NiHaoMike/OpenDAC-HD/OpenDAC.JPG

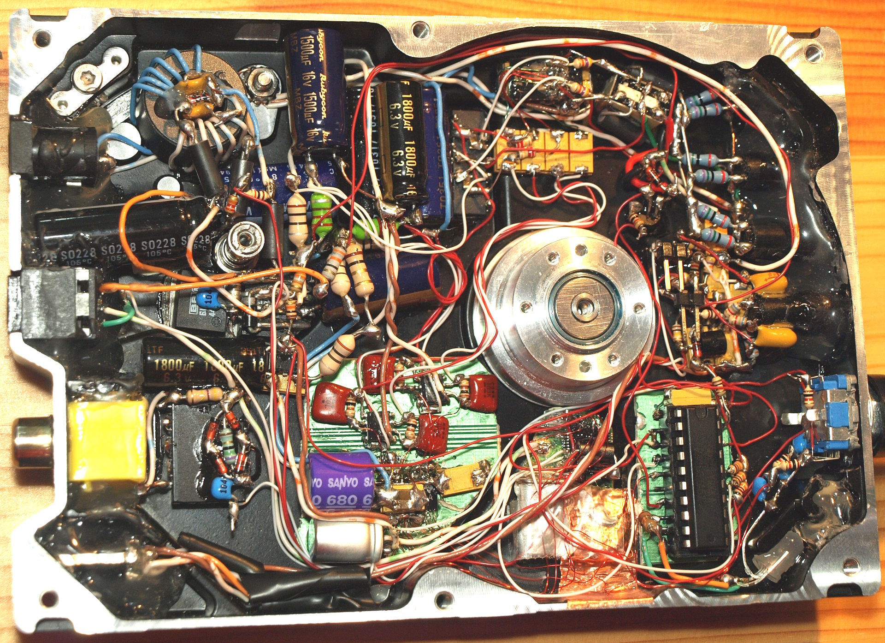
OpenDAC.JPG
