NiHaoMike/OpenDAC-HD/OpenDAC_sch_ana.png

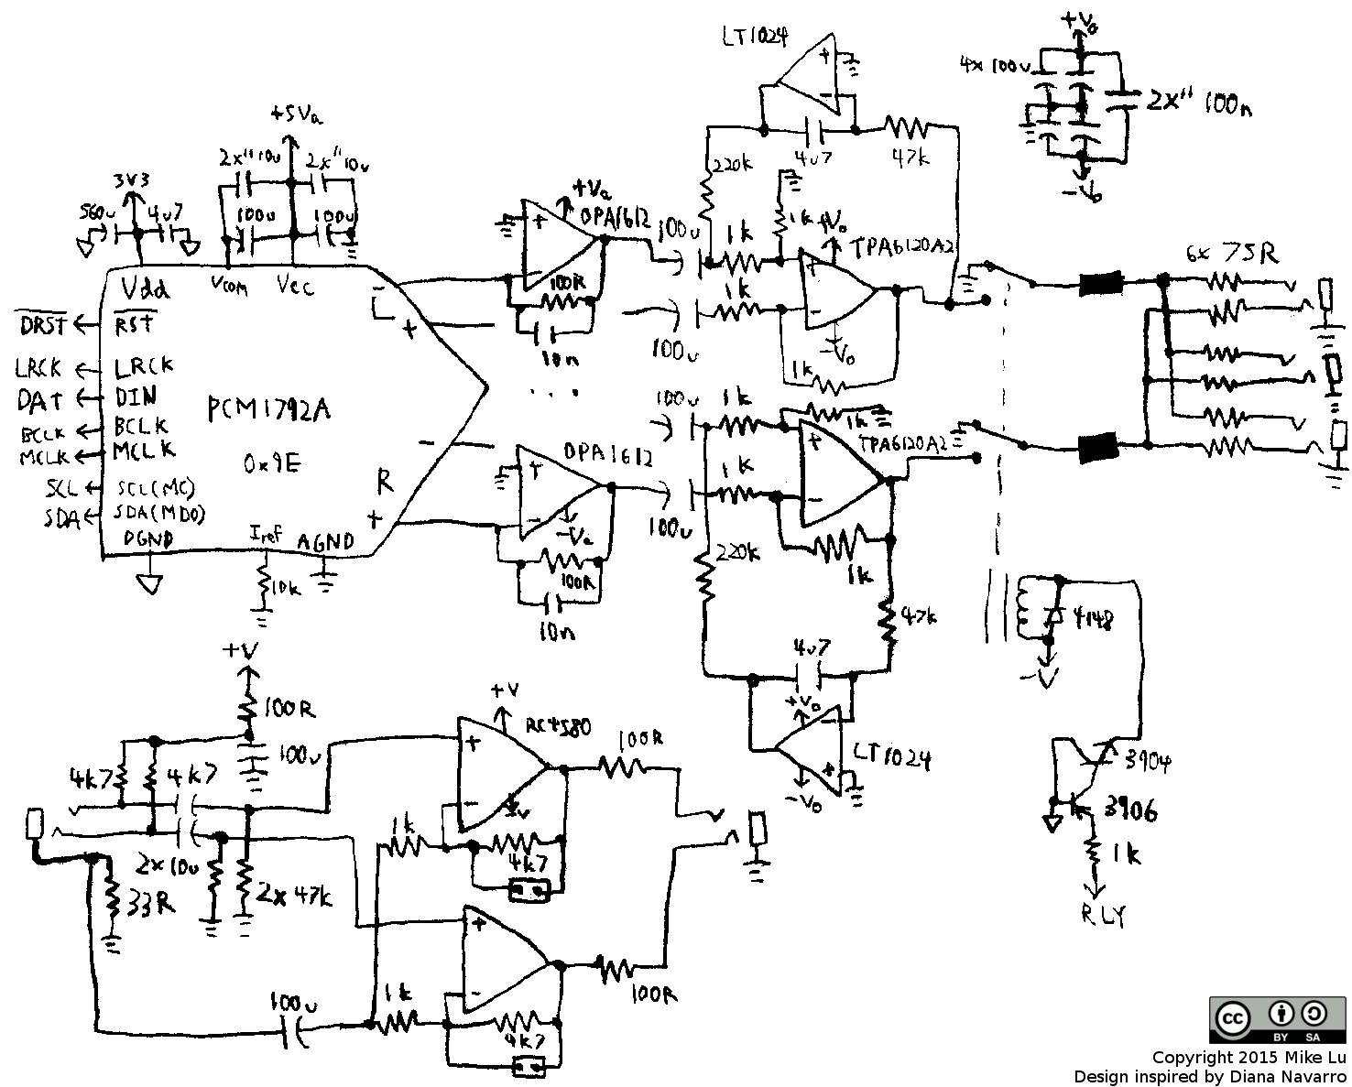
OpenDAC_sch_ana.png
