NiHaoMike/OpenDAC-HD/OpenDAC_sch_dig.png

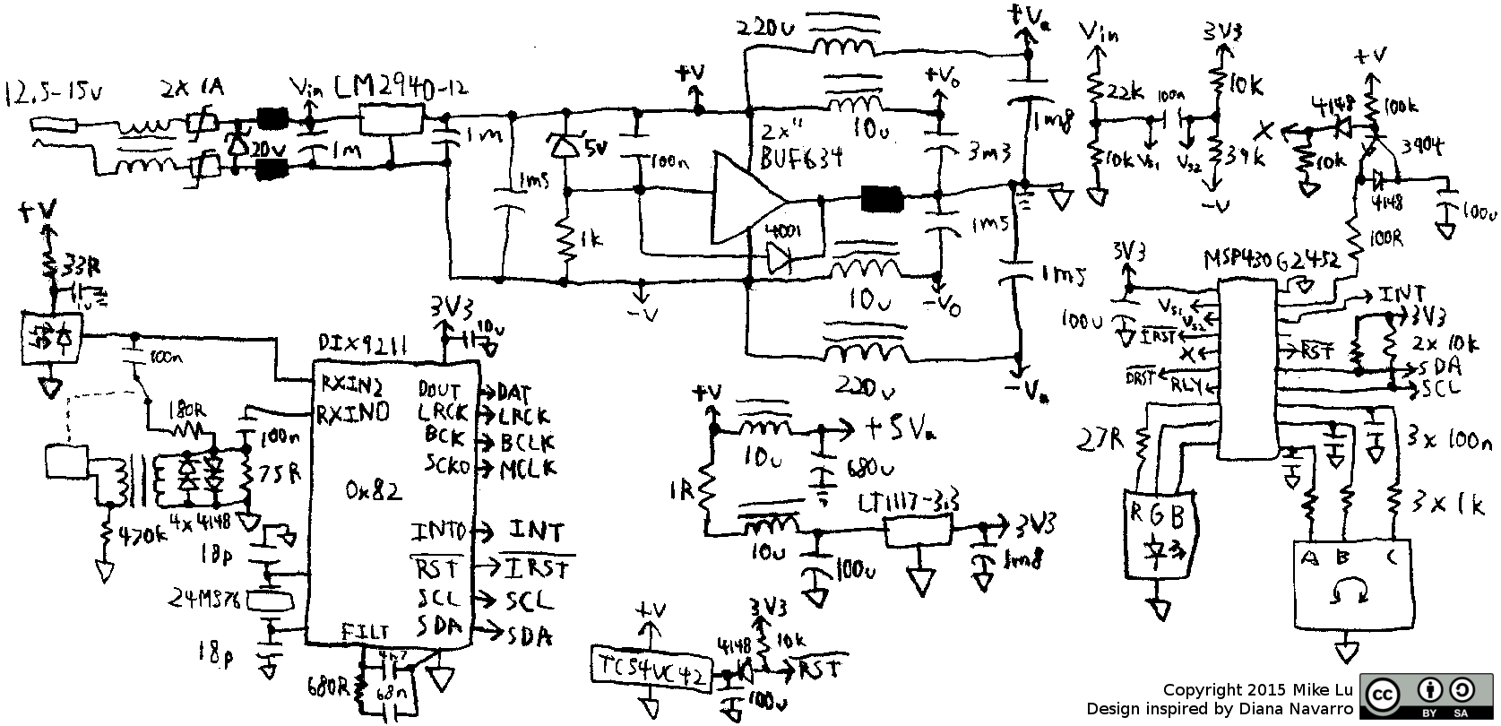
OpenDAC_sch_dig.png
