NiHaoMike/OpenDAC-HD/(threads)

Thread 2 (2023-12-18):

Add info about supported hardware to the README

DeflateAwning, 2023-12-18:
Is there an accompanying PCB or something? What device is this firmware meant to run on?

marcdraco, 2025-03-13:
Shouldn't be terribly difficult to design a PCB from the schematic, I'd be happy to do it but I'd want to know the thing works as advertised before I chucked money at it. :)

It's incredible to see someone with that level of skill rely on a hand-drawn schematic esp. when KiCAD (and a few other) EDAs are free and quite mature. More so in KiCAD these days as it's light years ahead of most of the competition.
